harshavardhan930/SPIN_COATER/3D Parts/Spin_coater_Square_holder_75x25.stl

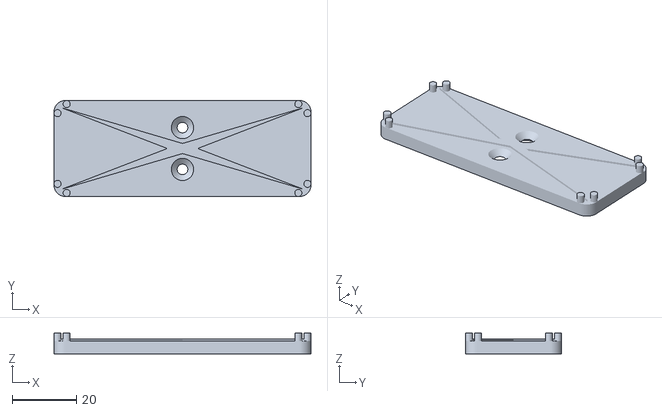
[picture p1: CAD file, 2026-10-23]
3D Parts/Spin_coater_Square_holder_75x25.stl
79.8 x 29.8 x 6.40
