harshavardhan930/SPIN_COATER/3D Parts/SPin_coater_Vase.stl

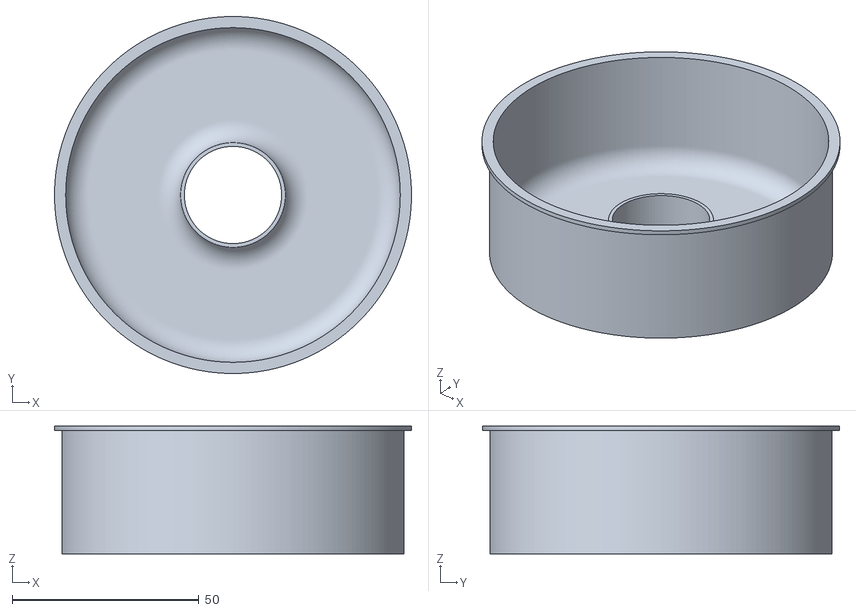
[picture p2: CAD file, 2026-10-23]
3D Parts/SPin_coater_Vase.stl
95.5 x 95.5 x 34.2
