harshavardhan930/SPIN_COATER/3D Parts/spin_coater_Shaft_adapter.stl

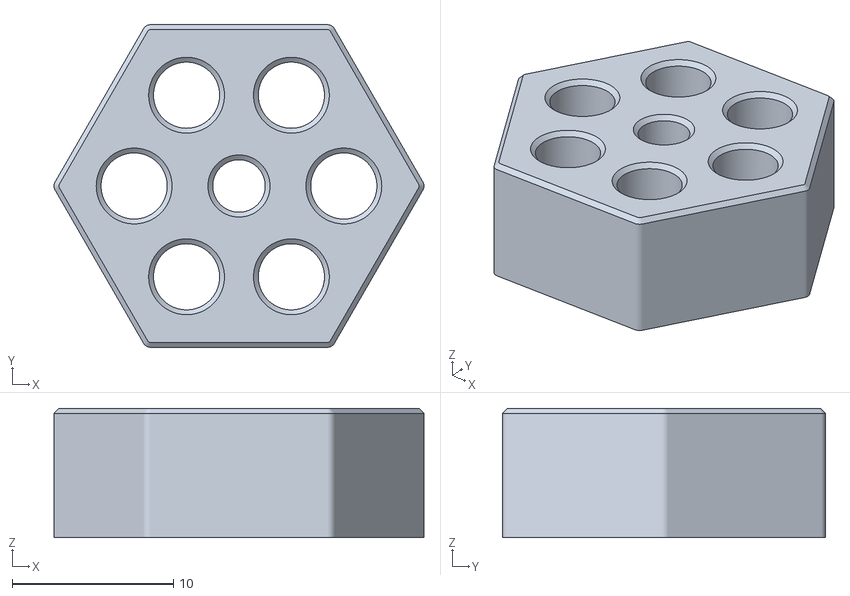
[picture p3: CAD file, 2026-10-23]
3D Parts/spin_coater_Shaft_adapter.stl
22.9 x 20.0 x 8.00
