harshavardhan930/SPIN_COATER/3D Parts/Spin_coater_Case.stl

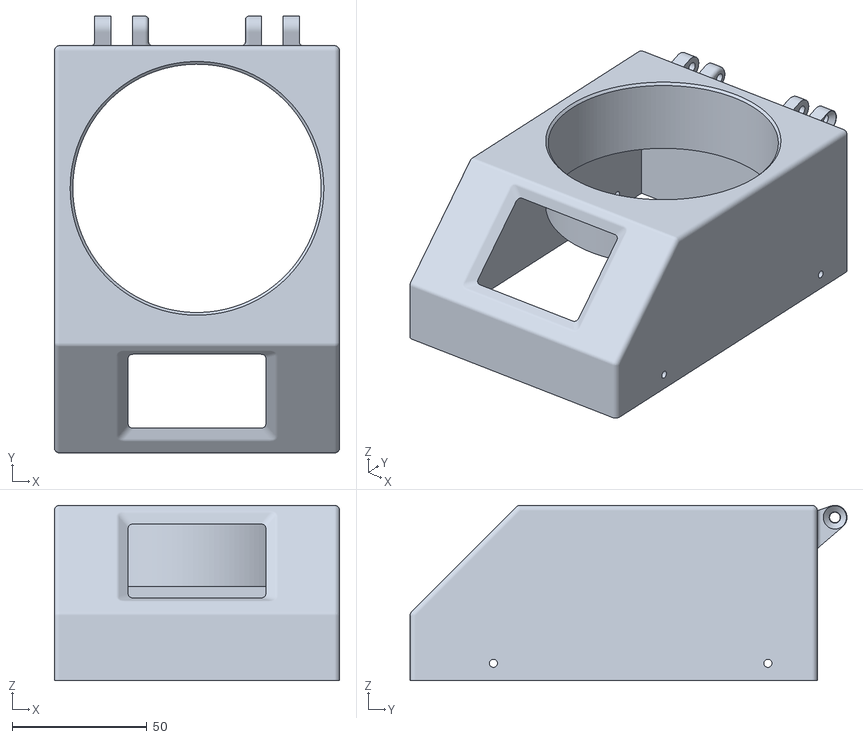
[picture p4: CAD file, 2026-10-23]
3D Parts/Spin_coater_Case.stl
105.8 x 162.0 x 65.0
