harshavardhan930/SPIN_COATER/3D Parts/Spin_coater_lid.stl

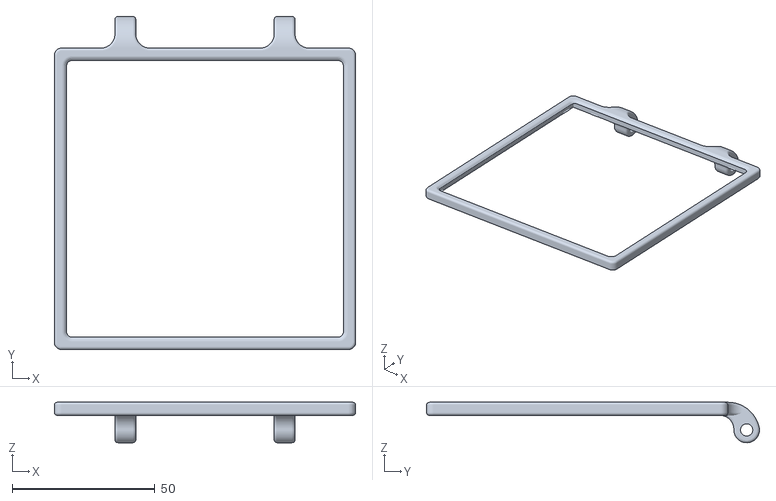
[picture p5: CAD file, 2026-10-23]
3D Parts/Spin_coater_lid.stl
105.6 x 116.7 x 14.2
