harshavardhan930/SPIN_COATER/3D Parts/spin_coatoer_Round_holder_18mm.stl

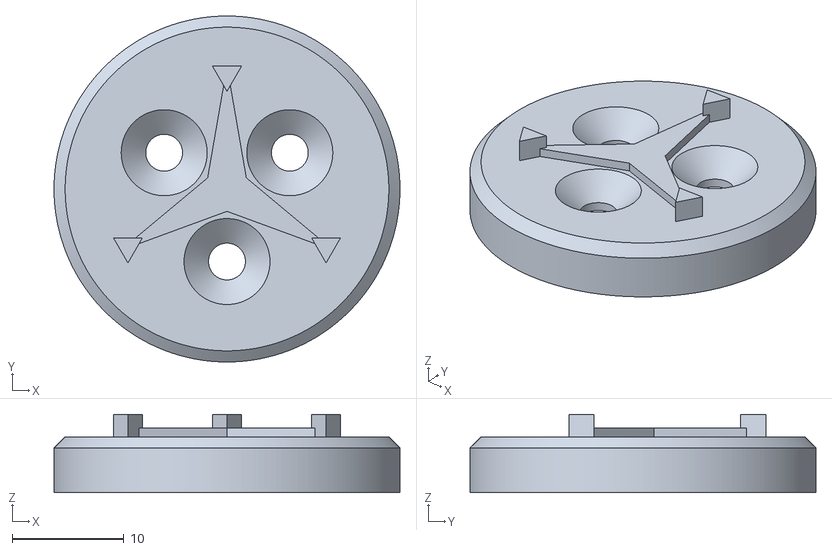
[picture p6: CAD file, 2026-10-23]
3D Parts/spin_coatoer_Round_holder_18mm.stl
31.0 x 31.0 x 7.00
