harshavardhan930/SPIN_COATER/3D Parts/Spin_coater_Base.stl

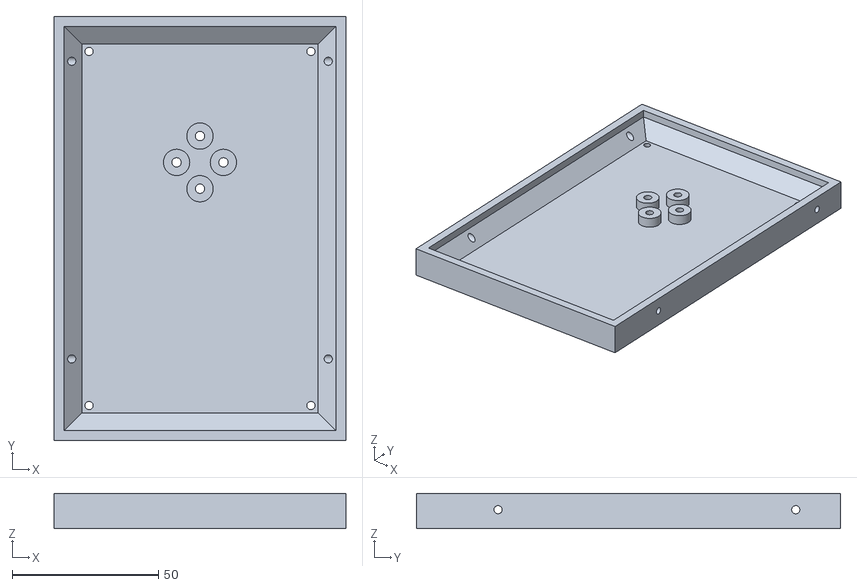
[picture p7: CAD file, 2026-10-23]
3D Parts/Spin_coater_Base.stl
99.8 x 145.0 x 12.0
