harshavardhan930/SPIN_COATER/Schemetic/Spin Coater Schemetic.pdf

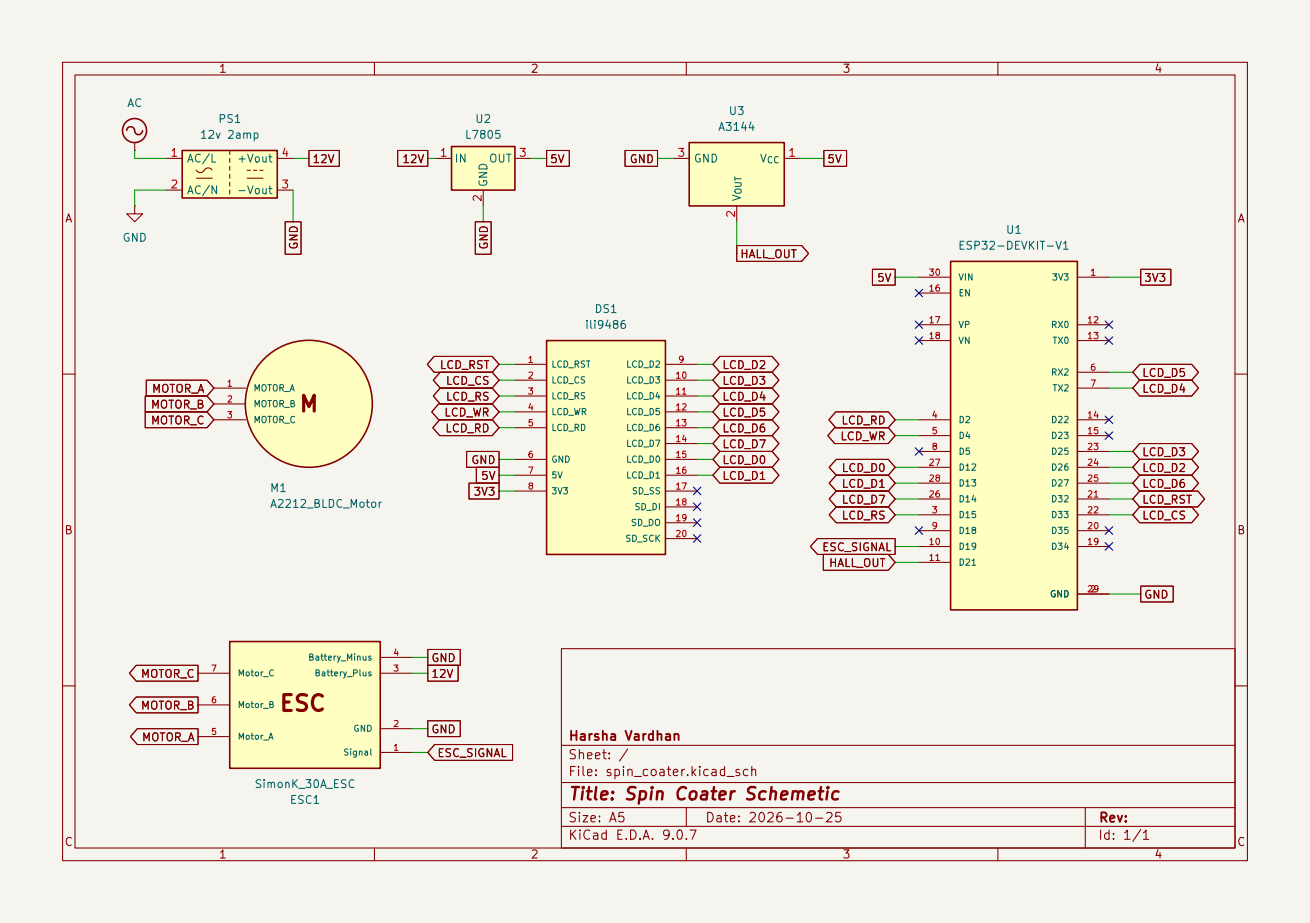
[picture p8: page 1]
