harshavardhan930/SPIN_COATER/Schemetic/spin_coater.kicad_sch

## KiCad design Schemetic/spin_coater.kicad_sch (2026-10-25)

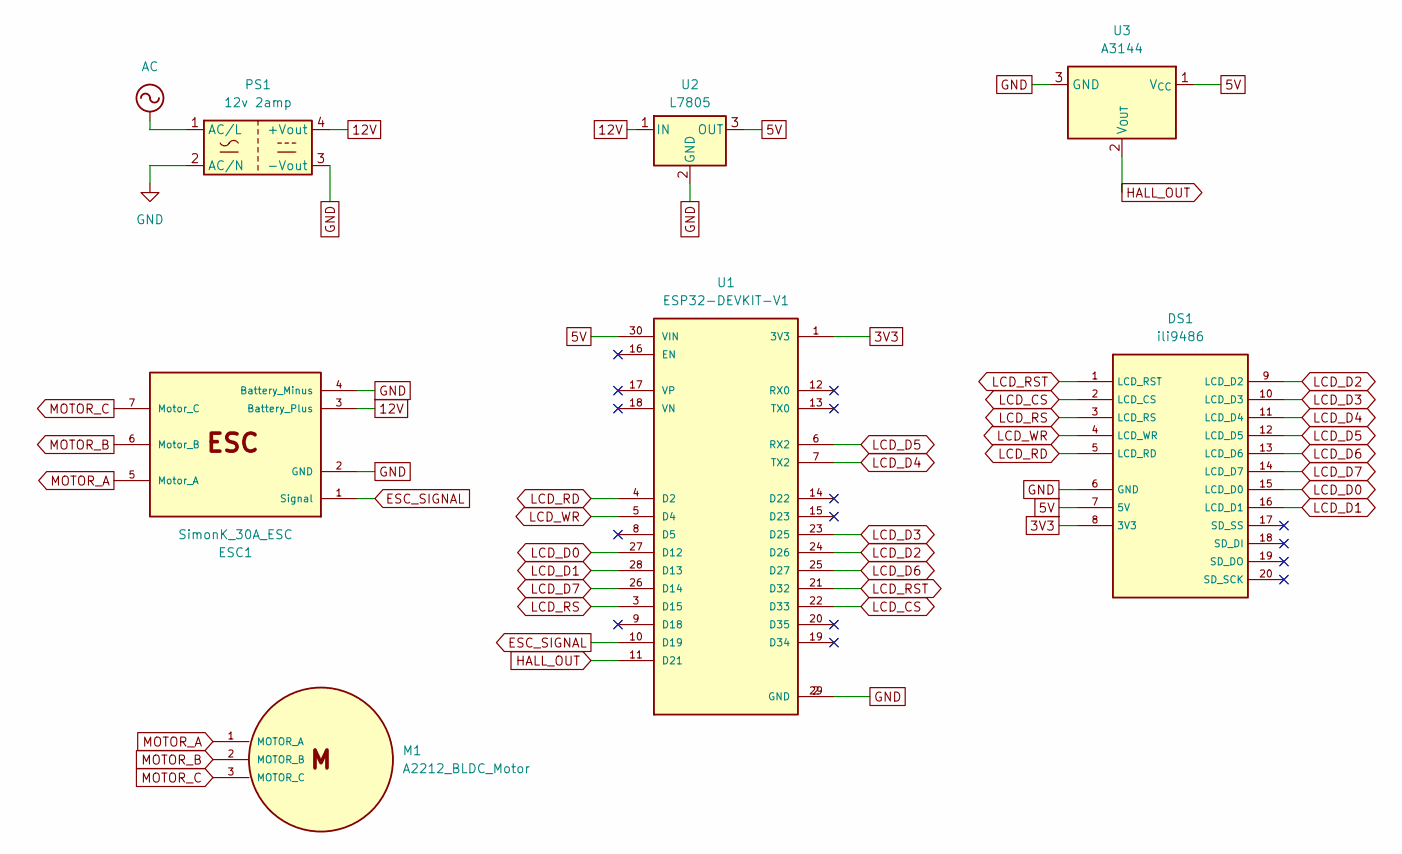
[picture p9: schematic spin_coater.kicad_sch]

Parts:
DS1: ili9486
ESC1: SimonK_30A_ESC
M1: A2212_BLDC_Motor
PS1: 12v 2amp; Converter_ACDC_Hi-Link_HLK-2Mxx
U1: ESP32-DEVKIT-V1; MODULE_ESP32_DEVKIT_V1; PARTREV N/A
U2: L7805
U3: A3144; SOT-23W

Connections:
3V3: DS1.8 (3V3), U1.1 (3V3)
5V: DS1.7 (5V), U1.30 (VIN), U2.3 (OUT), U3.1 (V_{CC})
12V: ESC1.3 (Battery_Plus), PS1.4 (+Vout), U2.1 (IN)
AC: PS1.1 (AC/L)
ESC_SIGNAL: ESC1.1 (Signal), U1.10 (D19)
GND: DS1.6 (GND), ESC1.2 (GND), ESC1.4 (Battery_Minus), PS1.2 (AC/N), PS1.3 (-Vout), U1.2 (GND), U1.29 (GND), U2.2 (GND), U3.3 (GND)
HALL_OUT: U1.11 (D21), U3.2 (V_{OUT})
LCD_CS: DS1.2 (LCD_CS), U1.22 (D33)
LCD_D0: DS1.15 (LCD_D0), U1.27 (D12)
LCD_D1: DS1.16 (LCD_D1), U1.28 (D13)
LCD_D2: DS1.9 (LCD_D2), U1.24 (D26)
LCD_D3: DS1.10 (LCD_D3), U1.23 (D25)
LCD_D4: DS1.11 (LCD_D4), U1.7 (TX2)
LCD_D5: DS1.12 (LCD_D5), U1.6 (RX2)
LCD_D6: DS1.13 (LCD_D6), U1.25 (D27)
LCD_D7: DS1.14 (LCD_D7), U1.26 (D14)
LCD_RD: DS1.5 (LCD_RD), U1.4 (D2)
LCD_RS: DS1.3 (LCD_RS), U1.3 (D15)
LCD_RST: DS1.1 (LCD_RST), U1.21 (D32)
LCD_WR: DS1.4 (LCD_WR), U1.5 (D4)
MOTOR_A: ESC1.5 (Motor_A), M1.1 (MOTOR_A)
MOTOR_B: ESC1.6 (Motor_B), M1.2 (MOTOR_B)
MOTOR_C: ESC1.7 (Motor_C), M1.3 (MOTOR_C)
