harshavardhan930/SPIN_COATER/code/screens.c

#include <string.h>

#include "screens.h"
#include "images.h"
#include "fonts.h"
#include "actions.h"
#include "vars.h"
#include "styles.h"
#include "ui.h"

#include <string.h>

objects_t objects;

//
// Event handlers
//

lv_obj_t *tick_value_change_obj;

//
// Screens
//

void create_screen_main() {
    lv_obj_t *obj = lv_obj_create(0);
    objects.main = obj;
    lv_obj_set_pos(obj, 0, 0);
    lv_obj_set_size(obj, 320, 240);
    {
        lv_obj_t *parent_obj = obj;
        {
            // main_panel
            lv_obj_t *obj = lv_obj_create(parent_obj);
            objects.main_panel = obj;
            lv_obj_set_pos(obj, 0, 0);
            lv_obj_set_size(obj, 320, 240);
            lv_obj_clear_flag(obj, LV_OBJ_FLAG_CLICKABLE|LV_OBJ_FLAG_CLICK_FOCUSABLE|LV_OBJ_FLAG_SCROLLABLE|LV_OBJ_FLAG_SCROLL_CHAIN_HOR|LV_OBJ_FLAG_SCROLL_CHAIN_VER|LV_OBJ_FLAG_SCROLL_ELASTIC|LV_OBJ_FLAG_SCROLL_MOMENTUM|LV_OBJ_FLAG_SCROLL_WITH_ARROW);
            {
                lv_obj_t *parent_obj = obj;
                {
                    lv_obj_t *obj = lv_label_create(parent_obj);
                    lv_obj_set_pos(obj, 157, 61);
                    lv_obj_set_size(obj, LV_SIZE_CONTENT, LV_SIZE_CONTENT);
                    lv_label_set_text_static(obj, "Sec");
                }
                {
                    lv_obj_t *obj = lv_label_create(parent_obj);
                    lv_obj_set_pos(obj, 159, 128);
                    lv_obj_set_size(obj, LV_SIZE_CONTENT, LV_SIZE_CONTENT);
                    lv_label_set_text_static(obj, "Sec");
                }
                {
                    lv_obj_t *obj = lv_label_create(parent_obj);
                    lv_obj_set_pos(obj, 153, -6);
                    lv_obj_set_size(obj, LV_SIZE_CONTENT, LV_SIZE_CONTENT);
                    lv_label_set_text_static(obj, "RPM");
                }
                {
                    // Stop_button
                    lv_obj_t *obj = lv_btn_create(parent_obj);
                    objects.stop_button = obj;
                    lv_obj_set_pos(obj, 225, 128);
                    lv_obj_set_size(obj, 72, 71);
                    lv_obj_set_style_bg_color(obj, lv_color_hex(0xf32121), LV_PART_MAIN | LV_STATE_DEFAULT);
                    {
                        lv_obj_t *parent_obj = obj;
                        {
                            lv_obj_t *obj = lv_label_create(parent_obj);
                            lv_obj_set_pos(obj, 0, 0);
                            lv_obj_set_size(obj, LV_SIZE_CONTENT, LV_SIZE_CONTENT);
                            lv_obj_set_style_align(obj, LV_ALIGN_CENTER, LV_PART_MAIN | LV_STATE_DEFAULT);
                            lv_obj_set_style_text_font(obj, &lv_font_montserrat_24, LV_PART_MAIN | LV_STATE_DEFAULT);
                            lv_label_set_text_static(obj, "Stop");
                        }
                    }
                }
                {
                    // Start_button
                    lv_obj_t *obj = lv_btn_create(parent_obj);
                    objects.start_button = obj;
                    lv_obj_set_pos(obj, 225, 57);
                    lv_obj_set_size(obj, 72, 67);
                    lv_obj_set_style_bg_color(obj, lv_color_lighten(lv_color_hex(0x129d2e), 0), LV_PART_MAIN | LV_STATE_DEFAULT);
                    {
                        lv_obj_t *parent_obj = obj;
                        {
                            lv_obj_t *obj = lv_label_create(parent_obj);
                            lv_obj_set_pos(obj, 0, 0);
                            lv_obj_set_size(obj, LV_SIZE_CONTENT, LV_SIZE_CONTENT);
                            lv_obj_set_style_align(obj, LV_ALIGN_CENTER, LV_PART_MAIN | LV_STATE_DEFAULT);
                            lv_obj_set_style_text_font(obj, &lv_font_montserrat_24, LV_PART_MAIN | LV_STATE_DEFAULT);
                            lv_label_set_text_static(obj, "Start");
                        }
                    }
                }
                {
                    // Coating_time_label
                    lv_obj_t *obj = lv_label_create(parent_obj);
                    objects.coating_time_label = obj;
                    lv_obj_set_pos(obj, -5, 146);
                    lv_obj_set_size(obj, LV_SIZE_CONTENT, LV_SIZE_CONTENT);
                    lv_obj_set_style_text_font(obj, &lv_font_montserrat_20, LV_PART_MAIN | LV_STATE_DEFAULT);
                    lv_label_set_text_static(obj, "Coating \ntime");
                }
                {
                    // Ramp_label
                    lv_obj_t *obj = lv_label_create(parent_obj);
                    objects.ramp_label = obj;
                    lv_obj_set_pos(obj, -5, 92);
                    lv_obj_set_size(obj, LV_SIZE_CONTENT, LV_SIZE_CONTENT);
                    lv_obj_set_style_text_font(obj, &lv_font_montserrat_20, LV_PART_MAIN | LV_STATE_DEFAULT);
                    lv_label_set_text_static(obj, "Ramp Time");
                }
                {
                    // Target_speed_label
                    lv_obj_t *obj = lv_label_create(parent_obj);
                    objects.target_speed_label = obj;
                    lv_obj_set_pos(obj, -8, 36);
                    lv_obj_set_size(obj, LV_SIZE_CONTENT, LV_SIZE_CONTENT);
                    lv_obj_set_style_text_font(obj, &lv_font_montserrat_18, LV_PART_MAIN | LV_STATE_DEFAULT);
                    lv_label_set_text_static(obj, "Target Speed");
                }
                {
                    // target_speed_Value_Enter_button
                    lv_obj_t *obj = lv_btn_create(parent_obj);
                    objects.target_speed_value_enter_button = obj;
                    lv_obj_set_pos(obj, 124, 11);
                    lv_obj_set_size(obj, 86, 50);
                    {
                        lv_obj_t *parent_obj = obj;
                        {
                            // target_speed_value_lable
                            lv_obj_t *obj = lv_label_create(parent_obj);
                            objects.target_speed_value_lable = obj;
                            lv_obj_set_pos(obj, 0, 0);
                            lv_obj_set_size(obj, LV_SIZE_CONTENT, LV_SIZE_CONTENT);
                            lv_obj_set_style_align(obj, LV_ALIGN_CENTER, LV_PART_MAIN | LV_STATE_DEFAULT);
                            lv_obj_set_style_text_font(obj, &lv_font_montserrat_24, LV_PART_MAIN | LV_STATE_DEFAULT);
                            lv_label_set_text_static(obj, "0");
                        }
                    }
                }
                {
                    // Ramp_speed_Value_Enter_button
                    lv_obj_t *obj = lv_btn_create(parent_obj);
                    objects.ramp_speed_value_enter_button = obj;
                    lv_obj_set_pos(obj, 124, 76);
                    lv_obj_set_size(obj, 86, 50);
                    {
                        lv_obj_t *parent_obj = obj;
                        {
                            // Ramp_speed_value_lable
                            lv_obj_t *obj = lv_label_create(parent_obj);
                            objects.ramp_speed_value_lable = obj;
                            lv_obj_set_pos(obj, 0, 0);
                            lv_obj_set_size(obj, LV_SIZE_CONTENT, LV_SIZE_CONTENT);
                            lv_obj_set_style_align(obj, LV_ALIGN_CENTER, LV_PART_MAIN | LV_STATE_DEFAULT);
                            lv_obj_set_style_text_font(obj, &lv_font_montserrat_24, LV_PART_MAIN | LV_STATE_DEFAULT);
                            lv_label_set_text_static(obj, "0");
                        }
                    }
                }
                {
                    // coating_time_Value_Enter_button
                    lv_obj_t *obj = lv_btn_create(parent_obj);
                    objects.coating_time_value_enter_button = obj;
                    lv_obj_set_pos(obj, 124, 144);
                    lv_obj_set_size(obj, 86, 50);
                    {
                        lv_obj_t *parent_obj = obj;
                        {
                            // coating_time_value_lable
                            lv_obj_t *obj = lv_label_create(parent_obj);
                            objects.coating_time_value_lable = obj;
                            lv_obj_set_pos(obj, 0, 0);
                            lv_obj_set_size(obj, LV_SIZE_CONTENT, LV_SIZE_CONTENT);
                            lv_obj_set_style_align(obj, LV_ALIGN_CENTER, LV_PART_MAIN | LV_STATE_DEFAULT);
                            lv_obj_set_style_text_font(obj, &lv_font_montserrat_24, LV_PART_MAIN | LV_STATE_DEFAULT);
                            lv_label_set_text_static(obj, "0");
                        }
                    }
                }
                {
                    // main_panel_select_option_save_dropdown
                    lv_obj_t *obj = lv_dropdown_create(parent_obj);
                    objects.main_panel_select_option_save_dropdown = obj;
                    lv_obj_set_pos(obj, -8, -6);
                    lv_obj_set_size(obj, 120, LV_SIZE_CONTENT);
                    lv_dropdown_set_options(obj, "Settings 1\nSettings 2\nSettings 3");
                    lv_dropdown_set_selected(obj, 0);
                    lv_obj_add_flag(obj, LV_OBJ_FLAG_CHECKABLE);
                    lv_obj_clear_flag(obj, LV_OBJ_FLAG_CLICK_FOCUSABLE|LV_OBJ_FLAG_PRESS_LOCK|LV_OBJ_FLAG_SCROLLABLE|LV_OBJ_FLAG_SCROLL_CHAIN_HOR|LV_OBJ_FLAG_SCROLL_CHAIN_VER|LV_OBJ_FLAG_SCROLL_ELASTIC|LV_OBJ_FLAG_SCROLL_MOMENTUM|LV_OBJ_FLAG_SCROLL_ON_FOCUS|LV_OBJ_FLAG_SCROLL_WITH_ARROW|LV_OBJ_FLAG_SNAPPABLE);
                    lv_obj_set_style_width(obj, 120, LV_PART_MAIN | LV_STATE_DEFAULT);
                    lv_obj_set_style_height(obj, 10193, LV_PART_MAIN | LV_STATE_DEFAULT);
                }
                {
                    // settings_button
                    lv_obj_t *obj = lv_btn_create(parent_obj);
                    objects.settings_button = obj;
                    lv_obj_set_pos(obj, 225, -9);
                    lv_obj_set_size(obj, 72, 61);
                    lv_obj_set_style_bg_color(obj, lv_color_hex(0x000000), LV_PART_MAIN | LV_STATE_DEFAULT);
                    {
                        lv_obj_t *parent_obj = obj;
                        {
                            lv_obj_t *obj = lv_label_create(parent_obj);
                            lv_obj_set_pos(obj, 0, 0);
                            lv_obj_set_size(obj, LV_SIZE_CONTENT, LV_SIZE_CONTENT);
                            lv_obj_set_style_align(obj, LV_ALIGN_CENTER, LV_PART_MAIN | LV_STATE_DEFAULT);
                            lv_obj_set_style_text_font(obj, &lv_font_montserrat_16, LV_PART_MAIN | LV_STATE_DEFAULT);
                            lv_obj_set_style_text_align(obj, LV_TEXT_ALIGN_CENTER, LV_PART_MAIN | LV_STATE_DEFAULT);
                            lv_label_set_text_static(obj, "Config");
                        }
                    }
                }
                {
                    // headding
                    lv_obj_t *obj = lv_label_create(parent_obj);
                    objects.headding = obj;
                    lv_obj_set_pos(obj, 75, 198);
                    lv_obj_set_size(obj, LV_SIZE_CONTENT, LV_SIZE_CONTENT);
                    lv_obj_set_style_text_font(obj, &lv_font_montserrat_24, LV_PART_MAIN | LV_STATE_DEFAULT);
                    lv_label_set_text_static(obj, "Spin Coater");
                }
            }
        }
        {
            // target_speed_panel
            lv_obj_t *obj = lv_obj_create(parent_obj);
            objects.target_speed_panel = obj;
            lv_obj_set_pos(obj, 0, 1);
            lv_obj_set_size(obj, 320, 239);
            lv_obj_clear_flag(obj, LV_OBJ_FLAG_CLICKABLE|LV_OBJ_FLAG_CLICK_FOCUSABLE|LV_OBJ_FLAG_SCROLLABLE|LV_OBJ_FLAG_SCROLL_CHAIN_HOR|LV_OBJ_FLAG_SCROLL_CHAIN_VER|LV_OBJ_FLAG_SCROLL_ELASTIC|LV_OBJ_FLAG_SCROLL_MOMENTUM|LV_OBJ_FLAG_SCROLL_WITH_ARROW);
            {
                lv_obj_t *parent_obj = obj;
                {
                    // target_speed_value_text_area
                    lv_obj_t *obj = lv_textarea_create(parent_obj);
                    objects.target_speed_value_text_area = obj;
                    lv_obj_set_pos(obj, -15, -16);
                    lv_obj_set_size(obj, 320, 27);
                    lv_textarea_set_max_length(obj, 128);
                    lv_textarea_set_placeholder_text(obj, "Enter Target Speed");
                    lv_textarea_set_one_line(obj, false);
                    lv_textarea_set_password_mode(obj, false);
                    lv_obj_clear_flag(obj, LV_OBJ_FLAG_PRESS_LOCK|LV_OBJ_FLAG_SCROLLABLE|LV_OBJ_FLAG_SCROLL_CHAIN_HOR|LV_OBJ_FLAG_SCROLL_CHAIN_VER|LV_OBJ_FLAG_SCROLL_ELASTIC|LV_OBJ_FLAG_SCROLL_MOMENTUM|LV_OBJ_FLAG_SCROLL_ON_FOCUS|LV_OBJ_FLAG_SCROLL_WITH_ARROW);
                }
                {
                    // target_speed_keypad
                    lv_obj_t *obj = lv_keyboard_create(parent_obj);
                    objects.target_speed_keypad = obj;
                    lv_obj_set_pos(obj, -15, 11);
                    lv_obj_set_size(obj, 320, 190);
                    lv_keyboard_set_mode(obj, LV_KEYBOARD_MODE_NUMBER);
                    lv_obj_set_style_align(obj, LV_ALIGN_DEFAULT, LV_PART_MAIN | LV_STATE_DEFAULT);
                }
            }
        }
        {
            // ramp_speed_panel
            lv_obj_t *obj = lv_obj_create(parent_obj);
            objects.ramp_speed_panel = obj;
            lv_obj_set_pos(obj, 0, 1);
            lv_obj_set_size(obj, 320, 239);
            lv_obj_add_flag(obj, LV_OBJ_FLAG_HIDDEN);
            lv_obj_clear_flag(obj, LV_OBJ_FLAG_CLICKABLE|LV_OBJ_FLAG_CLICK_FOCUSABLE|LV_OBJ_FLAG_SCROLLABLE|LV_OBJ_FLAG_SCROLL_CHAIN_HOR|LV_OBJ_FLAG_SCROLL_CHAIN_VER|LV_OBJ_FLAG_SCROLL_ELASTIC|LV_OBJ_FLAG_SCROLL_MOMENTUM|LV_OBJ_FLAG_SCROLL_WITH_ARROW|LV_OBJ_FLAG_SNAPPABLE);
            {
                lv_obj_t *parent_obj = obj;
                {
                    // Ramp_speed_value_text_area
                    lv_obj_t *obj = lv_textarea_create(parent_obj);
                    objects.ramp_speed_value_text_area = obj;
                    lv_obj_set_pos(obj, -15, -16);
                    lv_obj_set_size(obj, 320, 27);
                    lv_textarea_set_max_length(obj, 128);
                    lv_textarea_set_placeholder_text(obj, "Enter Ramp Time");
                    lv_textarea_set_one_line(obj, false);
                    lv_textarea_set_password_mode(obj, false);
                }
                {
                    // ramp_speed_keypad
                    lv_obj_t *obj = lv_keyboard_create(parent_obj);
                    objects.ramp_speed_keypad = obj;
                    lv_obj_set_pos(obj, -15, 11);
                    lv_obj_set_size(obj, 320, 190);
                    lv_keyboard_set_mode(obj, LV_KEYBOARD_MODE_NUMBER);
                    lv_obj_set_style_align(obj, LV_ALIGN_DEFAULT, LV_PART_MAIN | LV_STATE_DEFAULT);
                }
            }
        }
        {
            // coating_time_panel
            lv_obj_t *obj = lv_obj_create(parent_obj);
            objects.coating_time_panel = obj;
            lv_obj_set_pos(obj, 0, 1);
            lv_obj_set_size(obj, 320, 239);
            lv_obj_add_flag(obj, LV_OBJ_FLAG_HIDDEN);
            lv_obj_clear_flag(obj, LV_OBJ_FLAG_CLICKABLE|LV_OBJ_FLAG_CLICK_FOCUSABLE|LV_OBJ_FLAG_SCROLLABLE|LV_OBJ_FLAG_SCROLL_CHAIN_HOR|LV_OBJ_FLAG_SCROLL_CHAIN_VER|LV_OBJ_FLAG_SCROLL_ELASTIC|LV_OBJ_FLAG_SCROLL_MOMENTUM|LV_OBJ_FLAG_SCROLL_WITH_ARROW|LV_OBJ_FLAG_SNAPPABLE);
            {
                lv_obj_t *parent_obj = obj;
                {
                    // counting_time_value_text_area
                    lv_obj_t *obj = lv_textarea_create(parent_obj);
                    objects.counting_time_value_text_area = obj;
                    lv_obj_set_pos(obj, -15, -16);
                    lv_obj_set_size(obj, 320, 27);
                    lv_textarea_set_max_length(obj, 128);
                    lv_textarea_set_placeholder_text(obj, "enter coating time");
                    lv_textarea_set_one_line(obj, false);
                    lv_textarea_set_password_mode(obj, false);
                }
                {
                    // coating_time_keypad
                    lv_obj_t *obj = lv_keyboard_create(parent_obj);
                    objects.coating_time_keypad = obj;
                    lv_obj_set_pos(obj, -15, 11);
                    lv_obj_set_size(obj, 320, 190);
                    lv_keyboard_set_mode(obj, LV_KEYBOARD_MODE_NUMBER);
                    lv_obj_set_style_align(obj, LV_ALIGN_DEFAULT, LV_PART_MAIN | LV_STATE_DEFAULT);
                }
            }
        }
        {
            // parameter_save_setting_panel
            lv_obj_t *obj = lv_obj_create(parent_obj);
            objects.parameter_save_setting_panel = obj;
            lv_obj_set_pos(obj, 0, 0);
            lv_obj_set_size(obj, 320, 240);
            lv_obj_clear_flag(obj, LV_OBJ_FLAG_CLICKABLE|LV_OBJ_FLAG_CLICK_FOCUSABLE|LV_OBJ_FLAG_SCROLLABLE|LV_OBJ_FLAG_SCROLL_CHAIN_HOR|LV_OBJ_FLAG_SCROLL_CHAIN_VER|LV_OBJ_FLAG_SCROLL_ELASTIC|LV_OBJ_FLAG_SCROLL_MOMENTUM|LV_OBJ_FLAG_SCROLL_WITH_ARROW);
            {
                lv_obj_t *parent_obj = obj;
                {
                    // save_Coating_time_label
                    lv_obj_t *obj = lv_label_create(parent_obj);
                    objects.save_coating_time_label = obj;
                    lv_obj_set_pos(obj, -5, 181);
                    lv_obj_set_size(obj, LV_SIZE_CONTENT, LV_SIZE_CONTENT);
                    lv_obj_set_style_text_font(obj, &lv_font_montserrat_20, LV_PART_MAIN | LV_STATE_DEFAULT);
                    lv_label_set_text_static(obj, "Coating time");
                }
                {
                    // save_Ramp_speed_label
                    lv_obj_t *obj = lv_label_create(parent_obj);
                    objects.save_ramp_speed_label = obj;
                    lv_obj_set_pos(obj, -5, 126);
                    lv_obj_set_size(obj, LV_SIZE_CONTENT, LV_SIZE_CONTENT);
                    lv_obj_set_style_text_font(obj, &lv_font_montserrat_20, LV_PART_MAIN | LV_STATE_DEFAULT);
                    lv_label_set_text_static(obj, "Ramp Time");
                }
                {
                    // save_Target_speed_label
                    lv_obj_t *obj = lv_label_create(parent_obj);
                    objects.save_target_speed_label = obj;
                    lv_obj_set_pos(obj, -5, 75);
                    lv_obj_set_size(obj, LV_SIZE_CONTENT, LV_SIZE_CONTENT);
                    lv_obj_set_style_text_font(obj, &lv_font_montserrat_20, LV_PART_MAIN | LV_STATE_DEFAULT);
                    lv_obj_set_style_text_font(obj, &lv_font_montserrat_28, LV_PART_MAIN | LV_STATE_FOCUS_KEY);
                    lv_label_set_text(obj, "Target Speed");
                }
                {
                    // save_target_speed_Value_Enter_button
                    lv_obj_t *obj = lv_btn_create(parent_obj);
                    objects.save_target_speed_value_enter_button = obj;
                    lv_obj_set_pos(obj, 137, 61);
                    lv_obj_set_size(obj, 119, 50);
                    {
                        lv_obj_t *parent_obj = obj;
                        {
                            // save_target_speed_value_lable
                            lv_obj_t *obj = lv_label_create(parent_obj);
                            objects.save_target_speed_value_lable = obj;
                            lv_obj_set_pos(obj, 0, 0);
                            lv_obj_set_size(obj, LV_SIZE_CONTENT, LV_SIZE_CONTENT);
                            lv_obj_set_style_align(obj, LV_ALIGN_CENTER, LV_PART_MAIN | LV_STATE_DEFAULT);
                            lv_label_set_text_static(obj, "0");
                        }
                    }
                }
                {
                    // save_Ramp_speed_Value_Enter_button
                    lv_obj_t *obj = lv_btn_create(parent_obj);
                    objects.save_ramp_speed_value_enter_button = obj;
                    lv_obj_set_pos(obj, 137, 115);
                    lv_obj_set_size(obj, 119, 50);
                    {
                        lv_obj_t *parent_obj = obj;
                        {
                            // save_Ramp_speed_value_lable
                            lv_obj_t *obj = lv_label_create(parent_obj);
                            objects.save_ramp_speed_value_lable = obj;
                            lv_obj_set_pos(obj, 0, 0);
                            lv_obj_set_size(obj, LV_SIZE_CONTENT, LV_SIZE_CONTENT);
                            lv_obj_set_style_align(obj, LV_ALIGN_CENTER, LV_PART_MAIN | LV_STATE_DEFAULT);
                            lv_label_set_text_static(obj, "0");
                        }
                    }
                }
                {
                    // save_coating_time_Value_Enter_button
                    lv_obj_t *obj = lv_btn_create(parent_obj);
                    objects.save_coating_time_value_enter_button = obj;
                    lv_obj_set_pos(obj, 137, 170);
                    lv_obj_set_size(obj, 119, 50);
                    {
                        lv_obj_t *parent_obj = obj;
                        {
                            // save_coating_time_value_lable
                            lv_obj_t *obj = lv_label_create(parent_obj);
                            objects.save_coating_time_value_lable = obj;
                            lv_obj_set_pos(obj, 0, 0);
                            lv_obj_set_size(obj, LV_SIZE_CONTENT, LV_SIZE_CONTENT);
                            lv_obj_set_style_align(obj, LV_ALIGN_CENTER, LV_PART_MAIN | LV_STATE_DEFAULT);
                            lv_label_set_text_static(obj, "0");
                        }
                    }
                }
                {
                    // save_button
                    lv_obj_t *obj = lv_btn_create(parent_obj);
                    objects.save_button = obj;
                    lv_obj_set_pos(obj, 139, -11);
                    lv_obj_set_size(obj, 87, 62);
                    lv_obj_set_style_bg_color(obj, lv_color_hex(0xf32121), LV_PART_MAIN | LV_STATE_DEFAULT);
                    {
                        lv_obj_t *parent_obj = obj;
                        {
                            // save_button_lable
                            lv_obj_t *obj = lv_label_create(parent_obj);
                            objects.save_button_lable = obj;
                            lv_obj_set_pos(obj, 0, 0);
                            lv_obj_set_size(obj, LV_SIZE_CONTENT, LV_SIZE_CONTENT);
                            lv_obj_set_style_align(obj, LV_ALIGN_CENTER, LV_PART_MAIN | LV_STATE_DEFAULT);
                            lv_label_set_text_static(obj, "Save");
                        }
                    }
                }
                {
                    // headding_1
                    lv_obj_t *obj = lv_label_create(parent_obj);
                    objects.headding_1 = obj;
                    lv_obj_set_pos(obj, -12, -15);
                    lv_obj_set_size(obj, LV_SIZE_CONTENT, LV_SIZE_CONTENT);
                    lv_obj_set_style_text_font(obj, &lv_font_montserrat_18, LV_PART_MAIN | LV_STATE_DEFAULT);
                    lv_label_set_text_static(obj, "Save \nPerameters");
                }
                {
                    lv_obj_t *obj = lv_label_create(parent_obj);
                    lv_obj_set_pos(obj, 259, 80);
                    lv_obj_set_size(obj, LV_SIZE_CONTENT, LV_SIZE_CONTENT);
                    lv_label_set_text_static(obj, "Rpm");
                }
                {
                    lv_obj_t *obj = lv_label_create(parent_obj);
                    lv_obj_set_pos(obj, 259, 187);
                    lv_obj_set_size(obj, LV_SIZE_CONTENT, LV_SIZE_CONTENT);
                    lv_label_set_text_static(obj, "Sec");
                }
                {
                    lv_obj_t *obj = lv_label_create(parent_obj);
                    lv_obj_set_pos(obj, 259, 134);
                    lv_obj_set_size(obj, LV_SIZE_CONTENT, LV_SIZE_CONTENT);
                    lv_label_set_text_static(obj, "Sec");
                }
                {
                    // save_option_dropdown
                    lv_obj_t *obj = lv_dropdown_create(parent_obj);
                    objects.save_option_dropdown = obj;
                    lv_obj_set_pos(obj, -5, 25);
                    lv_obj_set_size(obj, 133, LV_SIZE_CONTENT);
                    lv_dropdown_set_options_static(obj, "Setting 1\nSetting 2\nSetting 3");
                    lv_dropdown_set_selected(obj, 0);
                    lv_obj_clear_flag(obj, LV_OBJ_FLAG_CLICK_FOCUSABLE|LV_OBJ_FLAG_SCROLLABLE|LV_OBJ_FLAG_SCROLL_CHAIN_HOR|LV_OBJ_FLAG_SCROLL_CHAIN_VER|LV_OBJ_FLAG_SCROLL_ELASTIC|LV_OBJ_FLAG_SCROLL_MOMENTUM|LV_OBJ_FLAG_SCROLL_ON_FOCUS|LV_OBJ_FLAG_SCROLL_WITH_ARROW);
                }
                {
                    // About_button
                    lv_obj_t *obj = lv_btn_create(parent_obj);
                    objects.about_button = obj;
                    lv_obj_set_pos(obj, 234, -11);
                    lv_obj_set_size(obj, 65, 62);
                    lv_obj_set_style_bg_color(obj, lv_color_hex(0x686868), LV_PART_MAIN | LV_STATE_DEFAULT);
                    {
                        lv_obj_t *parent_obj = obj;
                        {
                            lv_obj_t *obj = lv_label_create(parent_obj);
                            lv_obj_set_pos(obj, 0, 0);
                            lv_obj_set_size(obj, LV_SIZE_CONTENT, LV_SIZE_CONTENT);
                            lv_obj_set_style_align(obj, LV_ALIGN_CENTER, LV_PART_MAIN | LV_STATE_DEFAULT);
                            lv_label_set_text_static(obj, "About");
                        }
                    }
                }
            }
        }
        {
            // Splash_Screen
            lv_obj_t *obj = lv_obj_create(parent_obj);
            objects.splash_screen = obj;
            lv_obj_set_pos(obj, 0, -2);
            lv_obj_set_size(obj, 320, 242);
            lv_obj_add_flag(obj, LV_OBJ_FLAG_HIDDEN);
            lv_obj_clear_flag(obj, LV_OBJ_FLAG_CLICK_FOCUSABLE|LV_OBJ_FLAG_SCROLLABLE|LV_OBJ_FLAG_SCROLL_CHAIN_HOR|LV_OBJ_FLAG_SCROLL_CHAIN_VER|LV_OBJ_FLAG_SCROLL_ELASTIC|LV_OBJ_FLAG_SCROLL_MOMENTUM|LV_OBJ_FLAG_SCROLL_WITH_ARROW);
            {
                lv_obj_t *parent_obj = obj;
                {
                    lv_obj_t *obj = lv_spinner_create(parent_obj, 1000, 60);
                    lv_obj_set_pos(obj, 27, -6);
                    lv_obj_set_size(obj, 474, 228);
                }
                {
                    lv_obj_t *obj = lv_label_create(parent_obj);
                    lv_obj_set_pos(obj, 46, 94);
                    lv_obj_set_size(obj, LV_SIZE_CONTENT, LV_SIZE_CONTENT);
                    lv_obj_set_style_text_font(obj, &lv_font_montserrat_32, LV_PART_MAIN | LV_STATE_DEFAULT);
                    lv_label_set_text_static(obj, "Spin Coater");
                }
            }
        }
        {
            // About_panel
            lv_obj_t *obj = lv_obj_create(parent_obj);
            objects.about_panel = obj;
            lv_obj_set_pos(obj, 0, 0);
            lv_obj_set_size(obj, 320, 240);
            lv_obj_add_flag(obj, LV_OBJ_FLAG_HIDDEN);
            lv_obj_clear_flag(obj, LV_OBJ_FLAG_CLICK_FOCUSABLE|LV_OBJ_FLAG_SCROLLABLE|LV_OBJ_FLAG_SCROLL_CHAIN_HOR|LV_OBJ_FLAG_SCROLL_CHAIN_VER|LV_OBJ_FLAG_SCROLL_ELASTIC|LV_OBJ_FLAG_SCROLL_MOMENTUM|LV_OBJ_FLAG_SCROLL_WITH_ARROW);
            {
                lv_obj_t *parent_obj = obj;
                {
                    lv_obj_t *obj = lv_label_create(parent_obj);
                    objects.obj0 = obj;
                    lv_obj_set_pos(obj, 168, 201);
                    lv_obj_set_size(obj, LV_SIZE_CONTENT, LV_SIZE_CONTENT);
                    lv_obj_set_style_text_font(obj, &lv_font_montserrat_16, LV_PART_MAIN | LV_STATE_DEFAULT);
                    lv_obj_set_style_text_color(obj, lv_color_hex(0xff0f0f), LV_PART_MAIN | LV_STATE_DEFAULT);
                    lv_label_set_text_static(obj, "Harsha vardhan");
                }
                {
                    lv_obj_t *obj = lv_label_create(parent_obj);
                    lv_obj_set_pos(obj, 15, 106);
                    lv_obj_set_size(obj, LV_SIZE_CONTENT, LV_SIZE_CONTENT);
                    lv_obj_set_style_text_font(obj, &lv_font_montserrat_44, LV_PART_MAIN | LV_STATE_DEFAULT);
                    lv_label_set_text_static(obj, "9491978002");
                }
                {
                    lv_obj_t *obj = lv_label_create(parent_obj);
                    lv_obj_set_pos(obj, 100, 90);
                    lv_obj_set_size(obj, LV_SIZE_CONTENT, LV_SIZE_CONTENT);
                    lv_label_set_text_static(obj, "Contact Us:");
                }
                {
                    lv_obj_t *obj = lv_label_create(parent_obj);
                    lv_obj_set_pos(obj, 212, 185);
                    lv_obj_set_size(obj, LV_SIZE_CONTENT, LV_SIZE_CONTENT);
                    lv_obj_set_style_text_align(obj, LV_TEXT_ALIGN_CENTER, LV_PART_MAIN | LV_STATE_DEFAULT);
                    lv_label_set_text_static(obj, "your's");
                }
                {
                    // BACK_BUTTON
                    lv_obj_t *obj = lv_btn_create(parent_obj);
                    objects.back_button = obj;
                    lv_obj_set_pos(obj, -15, 175);
                    lv_obj_set_size(obj, 100, 50);
                    lv_obj_set_style_bg_color(obj, lv_color_hex(0xffffff), LV_PART_MAIN | LV_STATE_DEFAULT);
                    lv_obj_set_style_shadow_opa(obj, 0, LV_PART_MAIN | LV_STATE_DEFAULT);
                    {
                        lv_obj_t *parent_obj = obj;
                        {
                            lv_obj_t *obj = lv_label_create(parent_obj);
                            objects.obj1 = obj;
                            lv_obj_set_pos(obj, -21, 0);
                            lv_obj_set_size(obj, LV_SIZE_CONTENT, LV_SIZE_CONTENT);
                            lv_obj_set_style_align(obj, LV_ALIGN_CENTER, LV_PART_MAIN | LV_STATE_DEFAULT);
                            lv_obj_set_style_text_color(obj, lv_color_hex(0x484848), LV_PART_MAIN | LV_STATE_DEFAULT);
                            lv_label_set_text_static(obj, "BACK");
                        }
                    }
                }
                {
                    lv_obj_t *obj = lv_label_create(parent_obj);
                    lv_obj_set_pos(obj, -10, 24);
                    lv_obj_set_size(obj, LV_SIZE_CONTENT, LV_SIZE_CONTENT);
                    lv_obj_set_style_text_align(obj, LV_TEXT_ALIGN_CENTER, LV_PART_MAIN | LV_STATE_DEFAULT);
                    lv_label_set_text_static(obj, "if you want any projects or guidence about\n Embedded systems ");
                }
            }
        }
    }
    lv_keyboard_set_textarea(objects.target_speed_keypad, objects.target_speed_value_text_area);
    lv_keyboard_set_textarea(objects.ramp_speed_keypad, objects.ramp_speed_value_text_area);
    lv_keyboard_set_textarea(objects.coating_time_keypad, objects.counting_time_value_text_area);
    
    tick_screen_main();
}

void tick_screen_main() {
}

typedef void (*tick_screen_func_t)();
tick_screen_func_t tick_screen_funcs[] = {
    tick_screen_main,
};
void tick_screen(int screen_index) {
    if (screen_index >= 0 && screen_index < 1) {
        tick_screen_funcs[screen_index]();
    }
}
void tick_screen_by_id(enum ScreensEnum screenId) {
    tick_screen(screenId - 1);
}

//
// Fonts
//

ext_font_desc_t fonts[] = {
#if LV_FONT_MONTSERRAT_8
    { "MONTSERRAT_8", &lv_font_montserrat_8 },
#endif
#if LV_FONT_MONTSERRAT_10
    { "MONTSERRAT_10", &lv_font_montserrat_10 },
#endif
#if LV_FONT_MONTSERRAT_12
    { "MONTSERRAT_12", &lv_font_montserrat_12 },
#endif
#if LV_FONT_MONTSERRAT_14
    { "MONTSERRAT_14", &lv_font_montserrat_14 },
#endif
#if LV_FONT_MONTSERRAT_16
    { "MONTSERRAT_16", &lv_font_montserrat_16 },
#endif
#if LV_FONT_MONTSERRAT_18
    { "MONTSERRAT_18", &lv_font_montserrat_18 },
#endif
#if LV_FONT_MONTSERRAT_20
    { "MONTSERRAT_20", &lv_font_montserrat_20 },
#endif
#if LV_FONT_MONTSERRAT_22
    { "MONTSERRAT_22", &lv_font_montserrat_22 },
#endif
#if LV_FONT_MONTSERRAT_24
    { "MONTSERRAT_24", &lv_font_montserrat_24 },
#endif
#if LV_FONT_MONTSERRAT_26
    { "MONTSERRAT_26", &lv_font_montserrat_26 },
#endif
#if LV_FONT_MONTSERRAT_28
    { "MONTSERRAT_28", &lv_font_montserrat_28 },
#endif
#if LV_FONT_MONTSERRAT_30
    { "MONTSERRAT_30", &lv_font_montserrat_30 },
#endif
#if LV_FONT_MONTSERRAT_32
    { "MONTSERRAT_32", &lv_font_montserrat_32 },
#endif
#if LV_FONT_MONTSERRAT_34
    { "MONTSERRAT_34", &lv_font_montserrat_34 },
#endif
#if LV_FONT_MONTSERRAT_36
    { "MONTSERRAT_36", &lv_font_montserrat_36 },
#endif
#if LV_FONT_MONTSERRAT_38
    { "MONTSERRAT_38", &lv_font_montserrat_38 },
#endif
#if LV_FONT_MONTSERRAT_40
    { "MONTSERRAT_40", &lv_font_montserrat_40 },
#endif
#if LV_FONT_MONTSERRAT_42
    { "MONTSERRAT_42", &lv_font_montserrat_42 },
#endif
#if LV_FONT_MONTSERRAT_44
    { "MONTSERRAT_44", &lv_font_montserrat_44 },
#endif
#if LV_FONT_MONTSERRAT_46
    { "MONTSERRAT_46", &lv_font_montserrat_46 },
#endif
#if LV_FONT_MONTSERRAT_48
    { "MONTSERRAT_48", &lv_font_montserrat_48 },
#endif
};

//
// Color themes
//

uint32_t active_theme_index = 0;

//
//
//

void create_screens() {

// Set default LVGL theme
    lv_disp_t *dispp = lv_disp_get_default();
    lv_theme_t *theme = lv_theme_default_init(dispp, lv_palette_main(LV_PALETTE_BLUE), lv_palette_main(LV_PALETTE_RED), false, LV_FONT_DEFAULT);
    lv_disp_set_theme(dispp, theme);
    
    // Initialize screens
    // Create screens
    create_screen_main();
}
